Noath2302/Realization-Of-A-SensorShoe/README.md

# Realization-Of-A-SensorShoe
Thesis Project SoSe 2019
using sensor to build a plantar data measuring system.
Sensor : accelerator, angle velocity, ground repulsion force when walking.
Data was sent from Esp8266 to a hosting LAN server (socket running on a laptop, harder case for smartphones)

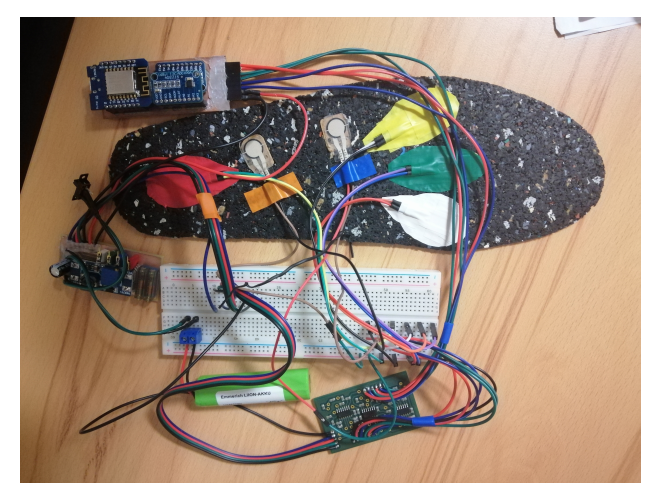
[picture p1: raw_setup.png]
probing setup


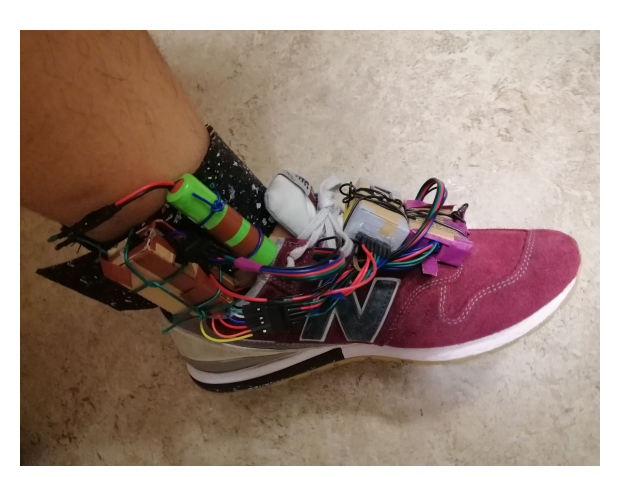
[picture p2: on_setup.png]
on foot setup


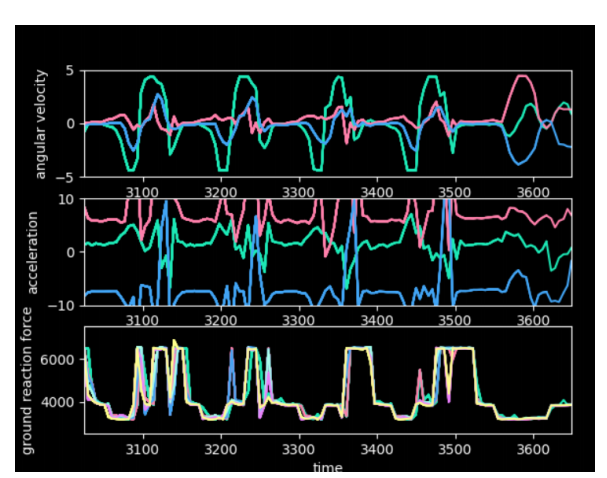
[picture p3: plot.png]
plot
