Noath2302/Realization-Of-A-SensorShoe/EaglePCB/dataBoard.png

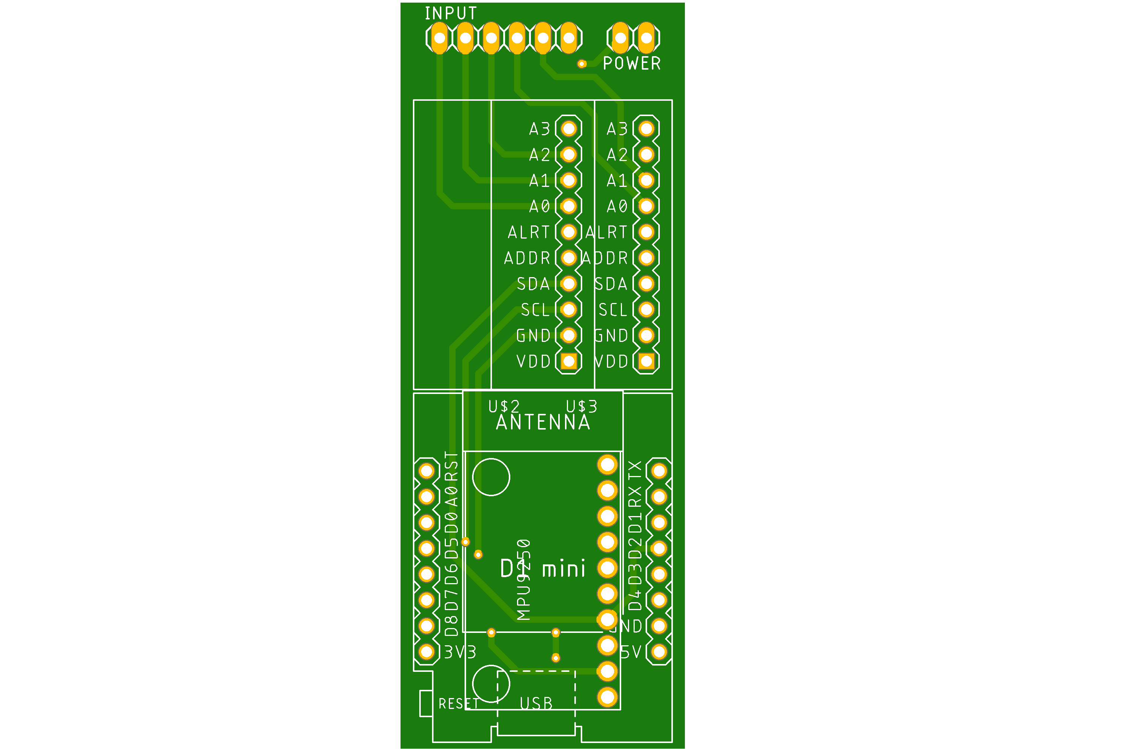
EaglePCB/dataBoard.png
