Noath2302/Realization-Of-A-SensorShoe/EaglePCB/ForceBoard.png

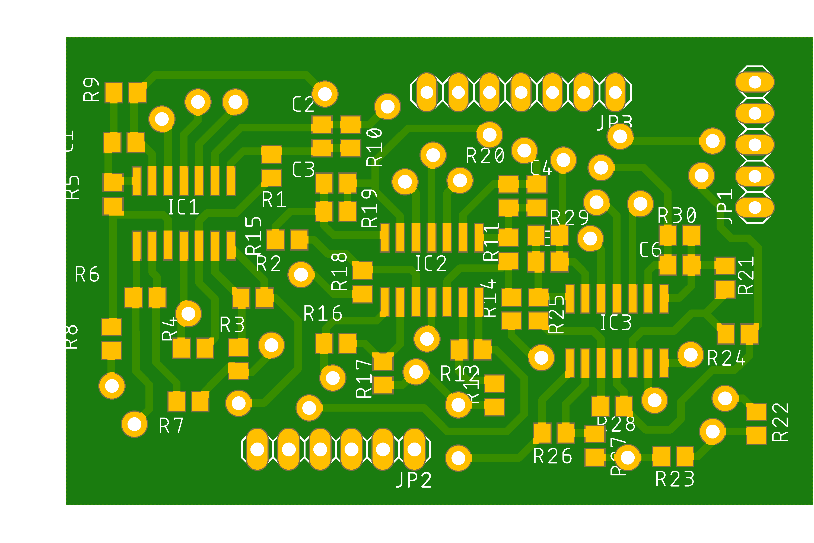
EaglePCB/ForceBoard.png
