Noath2302/Realization-Of-A-SensorShoe/EaglePCB/powerBoard.png

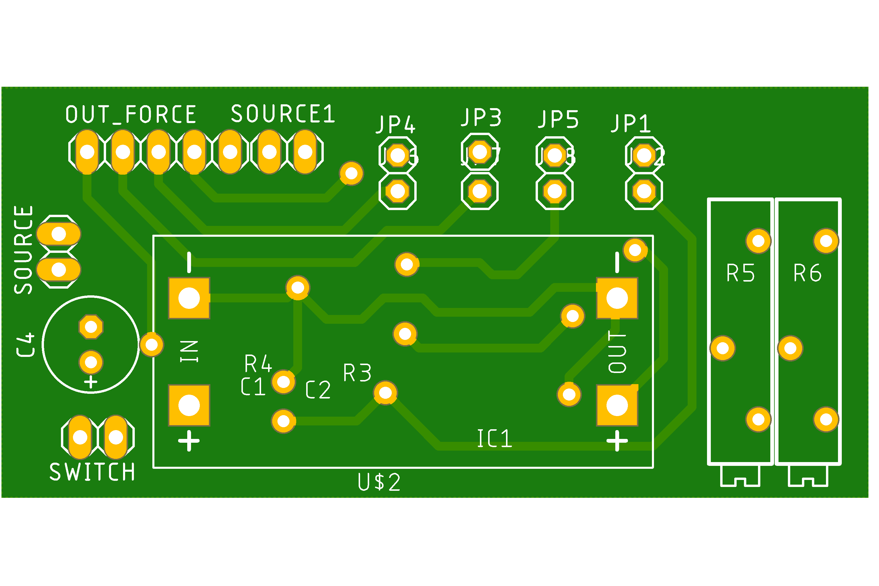
EaglePCB/powerBoard.png
