Noath2302/Realization-Of-A-SensorShoe/EaglePCB/powerBoard.brd

## EAGLE design EaglePCB/powerBoard.brd (2019-10-06)

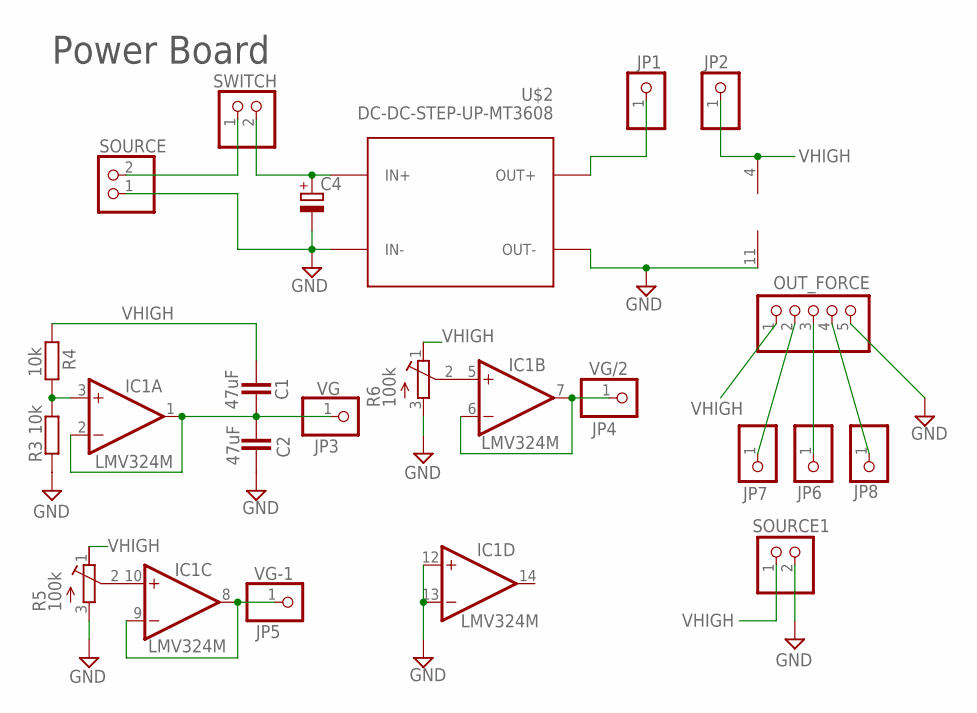
[picture p7: schematic powerBoard.sch]

Parts:
C1, C2: 47uF; C0805
C4: CPOL-EUE2.5-7; E2,5-7
IC1: LMV324M; SO14
JP1, JP2, JP3, JP4, JP5, JP6, JP7, JP8: PINHD-1X1; 1X01
OUT_FORCE: PINHD-1X5; 1X05
R3, R4: 10k; R0805
R5, R6: 100k; RTRIM3006P
SOURCE, SOURCE1: PINHD-1X2; 1X02
SWITCH: PINHD-1X2; 1X02
U$2: DC-DC-STEP-UP-MT3608

Connections:
GND: C2.2, C4.-, IC1.11 (V-), IC1.12 (+IN), IC1.13 (-IN), OUT_FORCE.5, R3.1, R5.3 (A), R6.3 (A), SOURCE.1, SOURCE1.2, U$2.IN-, U$2.OUT-
unnamed: JP1.1, U$2.OUT+
unnamed: IC1.3 (+IN), R3.2, R4.2
unnamed: SOURCE.2, SWITCH.1
unnamed: C4.+, SWITCH.2, U$2.IN+
unnamed: IC1.10 (+IN), R5.2 (S)
unnamed: IC1.5 (+IN), R6.2 (S)
unnamed: JP8.1, OUT_FORCE.4
unnamed: JP6.1, OUT_FORCE.3
unnamed: JP7.1, OUT_FORCE.2
VG: C1.2, C2.1, IC1.1 (OUT), IC1.2 (-IN), JP3.1
VG-1: IC1.8 (OUT), IC1.9 (-IN), JP5.1
VG/2: IC1.6 (-IN), IC1.7 (OUT), JP4.1
VHIGH: C1.1, IC1.4 (V+), JP2.1, OUT_FORCE.1, R4.1, R5.1 (E), R6.1 (E), SOURCE1.1

Notes on the sheet:
Power Board

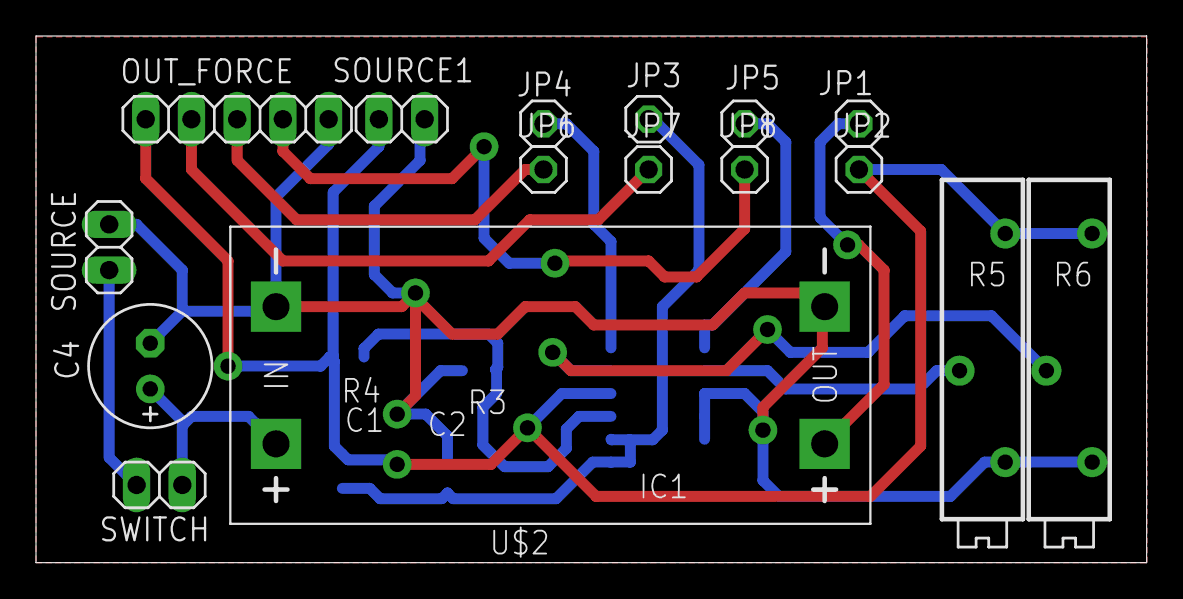
[picture p8: board powerBoard.brd from above]

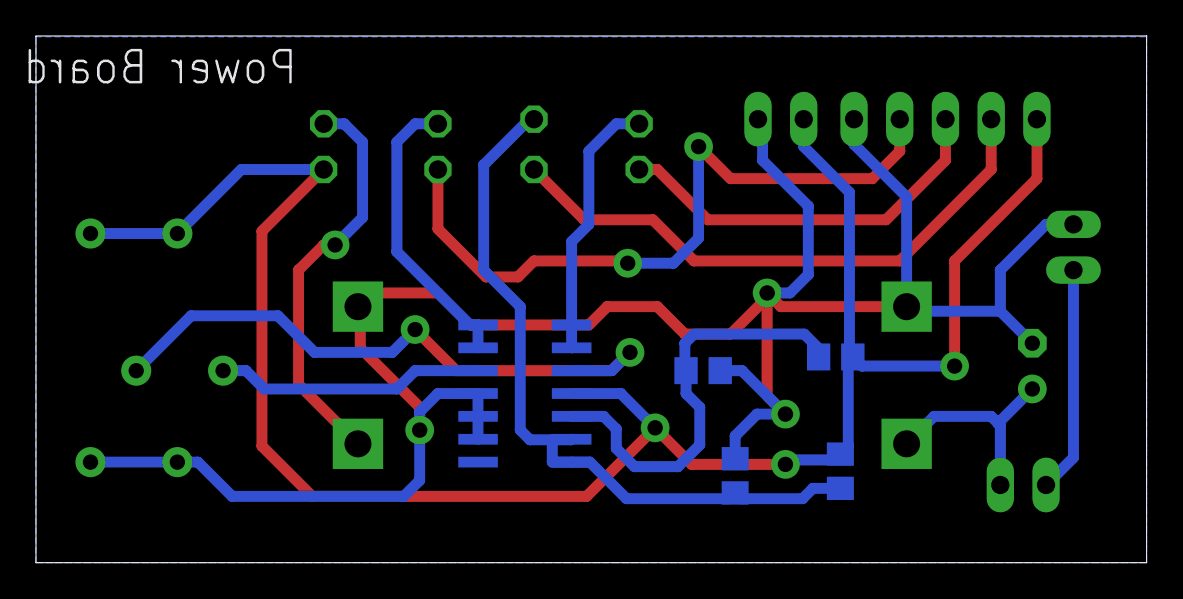
[picture p9: board powerBoard.brd from below]

Board: 2 copper layers, 61.7 x 29.3 mm, 21 parts (5 on the bottom side), 14 nets.
