Noath2302/Realization-Of-A-SensorShoe/EaglePCB/dataBoard.brd

## EAGLE design EaglePCB/dataBoard.brd (2019-10-06)

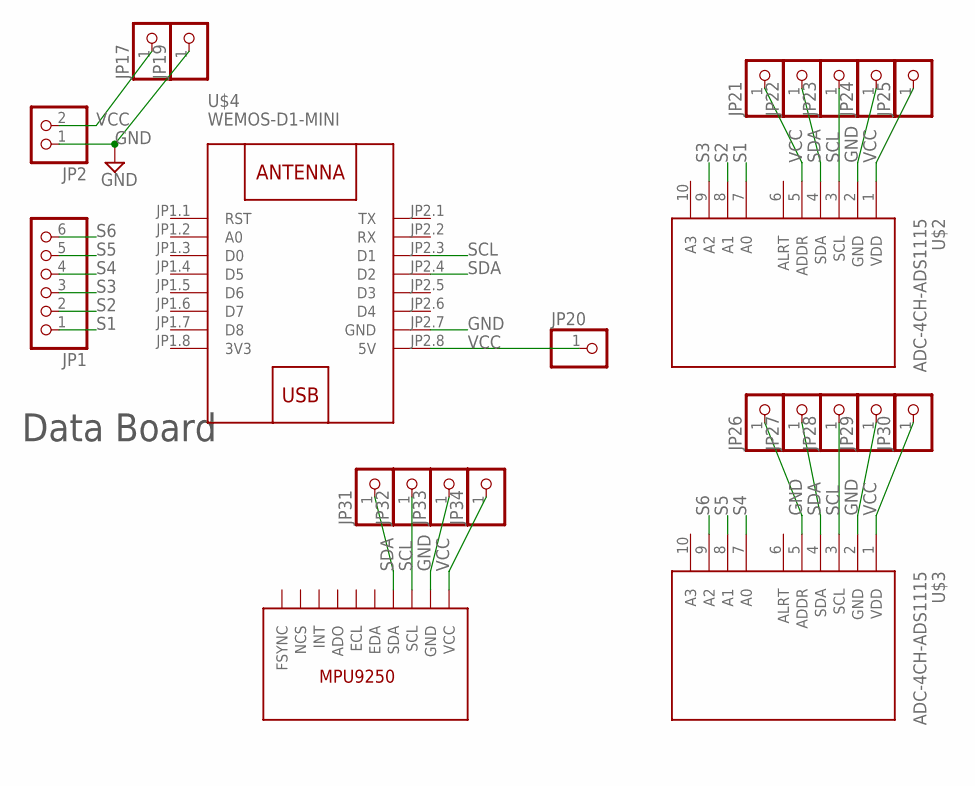
[picture p10: schematic dataBoard.sch]

Parts:
JP1: PINHD-1X6; 1X06
JP2: PINHD-1X2; 1X02
JP17, JP19, JP20, JP21, JP22, JP23, JP24, JP25, JP26, JP27, JP28, JP29, JP30, JP31, JP32, JP33, JP34: PINHD-1X1; 1X01
MPU1: MPU9250
U$2, U$3: ADC-4CH-ADS1115
U$4: WEMOS-D1-MINI

Connections:
3V3: U$4.JP1.8 (3V3)
GND: JP2.1, JP19.1, JP24.1, JP26.1, JP29.1, JP33.1, MPU1.GND, U$2.2 (GND), U$3.2 (GND), U$3.5 (ADDR), U$4.JP2.7 (GND)
S1: JP1.1, U$2.7 (A0)
S2: JP1.2, U$2.8 (A1)
S3: JP1.3, U$2.9 (A2)
S4: JP1.4, U$3.7 (A0)
S5: JP1.5, U$3.8 (A1)
S6: JP1.6, U$3.9 (A2)
SCL: JP23.1, JP28.1, JP32.1, MPU1.SCL, U$2.3 (SCL), U$3.3 (SCL), U$4.JP2.3 (D1)
SDA: JP22.1, JP27.1, JP31.1, MPU1.SDA, U$2.4 (SDA), U$3.4 (SDA), U$4.JP2.4 (D2)
VCC: JP2.2, JP17.1, JP20.1, JP21.1, JP25.1, JP30.1, JP34.1, MPU1.VCC, U$2.1 (VDD), U$2.5 (ADDR), U$3.1 (VDD), U$4.JP2.8 (5V)

Notes on the sheet:
Data Board

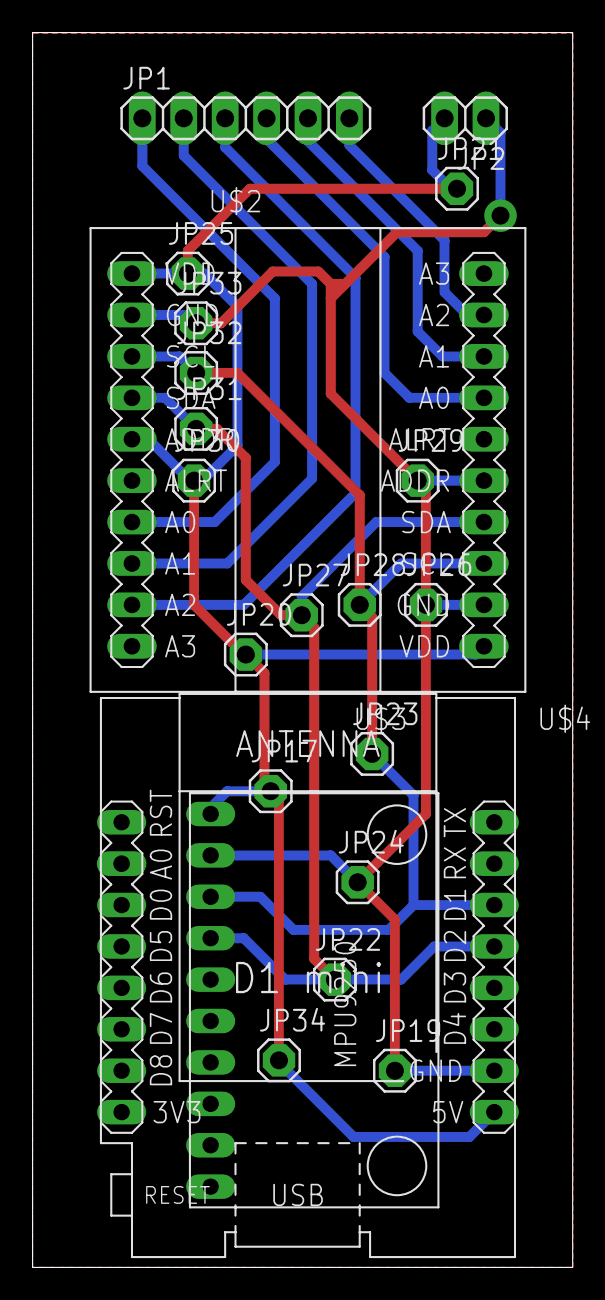
[picture p11: board dataBoard.brd from above]

Board: 2 copper layers, 33.1 x 75.7 mm, 23 parts (0 on the bottom side), 10 nets.
