Noath2302/Realization-Of-A-SensorShoe/EaglePCB/ForceBoard.brd

## EAGLE design EaglePCB/ForceBoard.brd (2019-10-06)

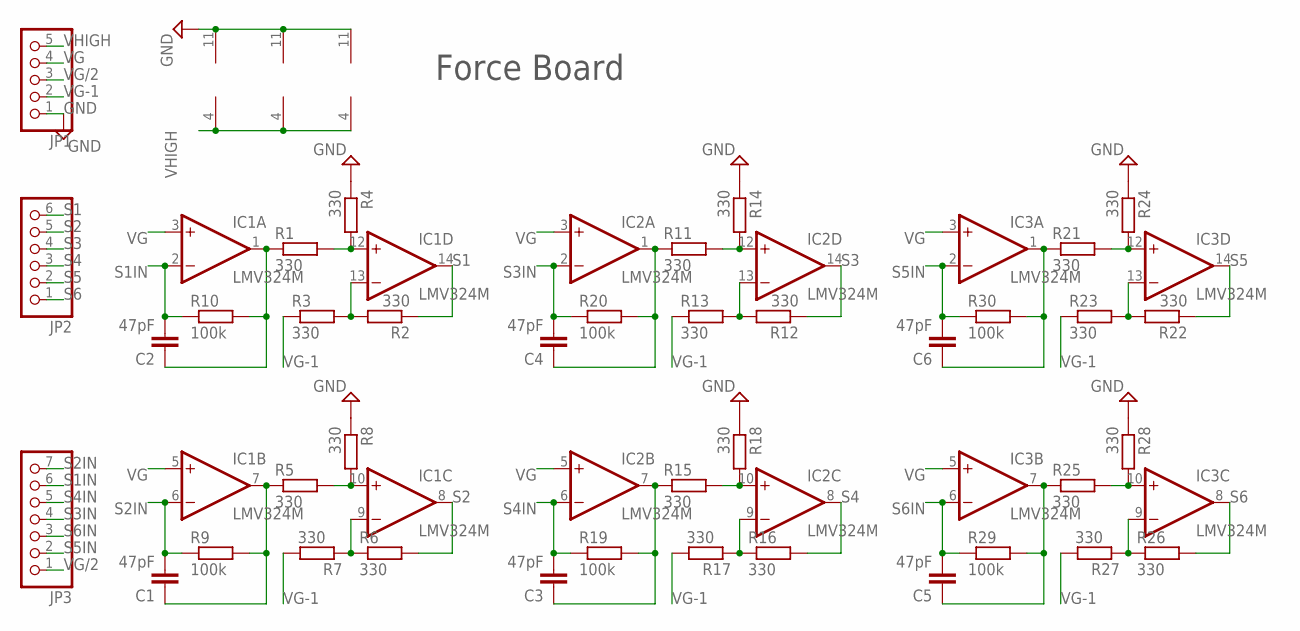
[picture p12: schematic ForceBoard.sch]

Parts:
C1, C2, C3, C4, C5, C6: 47pF; C0805
IC1, IC2, IC3: LMV324M; SO14
JP1: PINHD-1X5; 1X05
JP2: PINHD-1X6; 1X06
JP3: PINHD-1X7; 1X07
R1, R2, R3, R4, R5, R6, R7, R8, R11, R12, R13, R14, R15, R16, R17, R18, R21, R22, R23, R24, R25, R26, R27, R28: 330; R0805
R9, R10, R19, R20, R29, R30: 100k; R0805

Connections:
GND: IC1.11 (V-), IC2.11 (V-), IC3.11 (V-), JP1.1, R4.1, R8.1, R14.1, R18.1, R24.1, R28.1
unnamed: IC2.13 (-IN), R12.2, R13.2
unnamed: IC1.10 (+IN), R5.2, R8.2
unnamed: IC1.13 (-IN), R2.2, R3.2
unnamed: C1.1, IC1.7 (OUT), R5.1, R9.2
unnamed: IC1.9 (-IN), R6.1, R7.1
unnamed: IC1.12 (+IN), R1.2, R4.2
unnamed: C3.1, IC2.7 (OUT), R15.1, R19.2
unnamed: IC2.9 (-IN), R16.1, R17.1
unnamed: C2.1, IC1.1 (OUT), R1.1, R10.2
unnamed: IC2.10 (+IN), R15.2, R18.2
unnamed: IC2.12 (+IN), R11.2, R14.2
unnamed: C4.1, IC2.1 (OUT), R11.1, R20.2
unnamed: IC3.13 (-IN), R22.2, R23.2
unnamed: C5.1, IC3.7 (OUT), R25.1, R29.2
unnamed: IC3.9 (-IN), R26.1, R27.1
unnamed: IC3.10 (+IN), R25.2, R28.2
unnamed: IC3.12 (+IN), R21.2, R24.2
unnamed: C6.1, IC3.1 (OUT), R21.1, R30.2
S1: IC1.14 (OUT), JP2.6, R2.1
S1IN: C2.2, IC1.2 (-IN), JP3.6, R10.1
S2: IC1.8 (OUT), JP2.5, R6.2
S2IN: C1.2, IC1.6 (-IN), JP3.7, R9.1
S3: IC2.14 (OUT), JP2.4, R12.1
S3IN: C4.2, IC2.2 (-IN), JP3.4, R20.1
S4: IC2.8 (OUT), JP2.3, R16.2
S4IN: C3.2, IC2.6 (-IN), JP3.5, R19.1
S5: IC3.14 (OUT), JP2.2, R22.1
S5IN: C6.2, IC3.2 (-IN), JP3.2, R30.1
S6: IC3.8 (OUT), JP2.1, R26.2
S6IN: C5.2, IC3.6 (-IN), JP3.3, R29.1
VG: IC1.3 (+IN), IC1.5 (+IN), IC2.3 (+IN), IC2.5 (+IN), IC3.3 (+IN), IC3.5 (+IN), JP1.4
VG-1: JP1.2, R3.1, R7.2, R13.1, R17.2, R23.1, R27.2
VG/2: JP1.3, JP3.1
VHIGH: IC1.4 (V+), IC2.4 (V+), IC3.4 (V+), JP1.5

Notes on the sheet:
Force Board

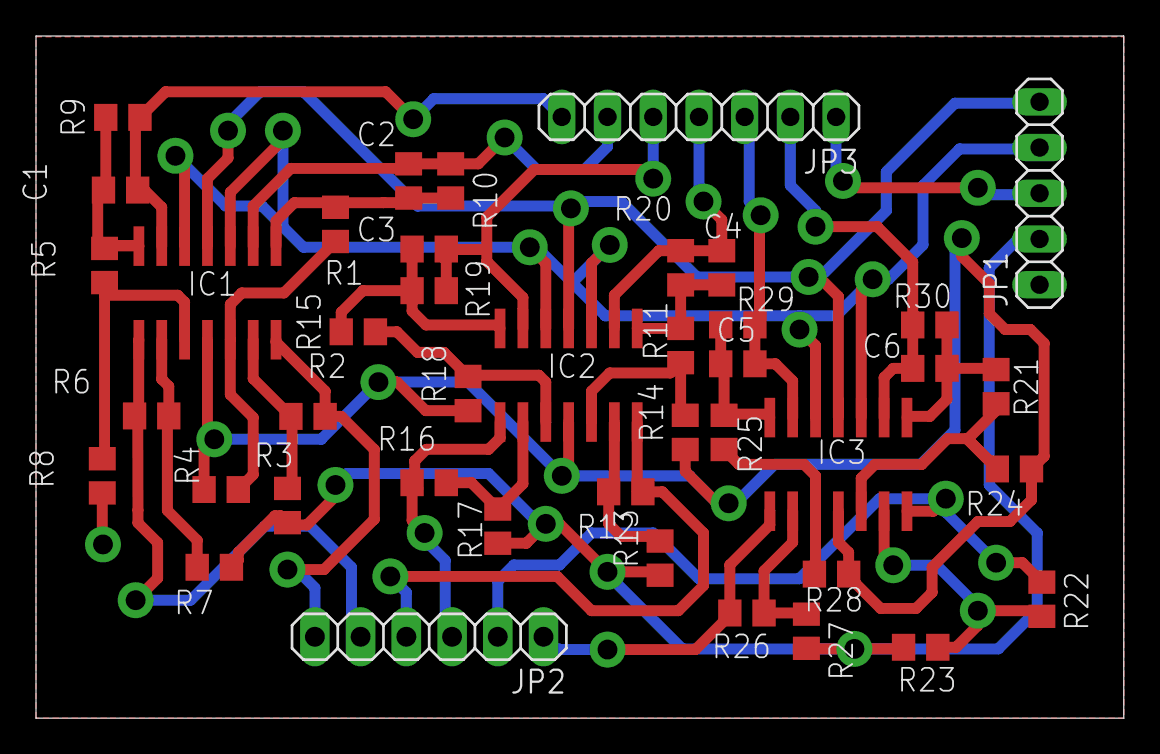
[picture p13: board ForceBoard.brd from above]

Board: 2 copper layers, 60.4 x 37.9 mm, 42 parts (0 on the bottom side), 35 nets.
