Noath2302/Realization-Of-A-SensorShoe/(commit log)

2019-10-09 remove unnescessary files
    [AllmoduleTest_4_take1.xlsx, BOM_wirelessShoe.xlsx, ForceBoard.brd, ForceBoard.sch, dataBoard.brd, dataBoard.sch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]
2020-08-15 adding Eagle PCBs
    [ForceBoard.brd, ForceBoard.sch, dataBoard.brd, dataBoard.sch, powerBoard.brd, powerBoard.sch]
