Noath2302/Realization-Of-A-SensorShoe/(notices)

Notices in the files:
parts and their libraries:
diy-modules_me: Released under the Creative Commons Attribution 4.0 International License: http://creativecommons.org/licenses/by/4.0
